furkhangul/Handpilot-Car/docs/templates/HAFTALIK_RAPOR.md

# HandPilot-Car · Haftalık Rapor H? (GG–GG Ay 2026)

**Ekip:** Furkan Gül · Sibel Akardaş · Hazal Kanik · Sinem Bolat · Reyyan Ceyda Can · Recep Özkan · Sefa Eren Yalçın · Amadou Billy Sidibe

## Haftanın özeti

<!-- 2–3 cümle: bu hafta hangi kapıdan geçildi, hangi çıktı var? -->

## Yapılanlar

| Tarih | İş | Sorumlu | Çıktı |
|---|---|---|---|
| | | | |

## Ölçümler

| Kriter | Hedef | Bu hafta | Durum |
|---|---|---|---|
| K? | | | ✅ / ⚠️ / ❌ |

## Sorunlar ve çözümler

| Sorun | Etki | Çözüm / karar |
|---|---|---|
| | | |

## Gelecek haftaya devreden

-

## Cuma çıktısı

- Video: <!-- link -->
- Log / grafik: <!-- link -->
