furkhangul/Handpilot-Car/docs/templates/RIZA_FORMU.md

# Açık Rıza Formu · HandPilot-Car Veri Seti

> Şablon. Çıktısı alınıp imzalanır; **imzalı formlar repoya yüklenmez**, ekip liderinde saklanır (README §9.7).

**Proje:** HandPilot-Car — el hareketiyle sürülen araç (ders projesi)
**Veri sorumlusu (ekip lideri):** Furkan Gül

## Toplanan veri

- Laptop kamerasıyla çekilen el hareketi fotoğrafları (640×480). Fotoğraflarda **yüzüm de görünebilir**.
- Her fotoğrafın hangi hareket, tur ve zamana ait olduğunu gösteren kayıt dosyası.
- Gerçek adım yerine bir **katılımcı kodu** kullanılır: `p__`.

## Amaç ve süre

- Veri **yalnızca** bu ders projesinde hareket tanıma modelini eğitmek ve test etmek için kullanılır.
- Ham görüntüler herkese açık bir yere (GitHub dahil) yüklenmez. Repoya yalnızca yüz içermeyen sayısal el noktaları (`landmarks.csv`) girebilir.
- Saklama süresi: proje bitimi + 1 yıl. Sonra silinir.

## Haklarım

- Rızamı istediğim zaman geri çekebilirim; verilerim silinir ve model yeniden eğitilir.
- Verilerimin silindiğine dair bilgi isteyebilirim.

Yukarıdakileri okudum ve el hareketi fotoğraflarımın bu amaçla kullanılmasına **açık rıza veriyorum**.

| | |
|---|---|
| Ad Soyad | |
| Katılımcı kodu | p__ |
| Tarih | |
| İmza | |
