furkhangul/Handpilot-Car/models/furkan/v1_cnn/figures/finetune_loss.png

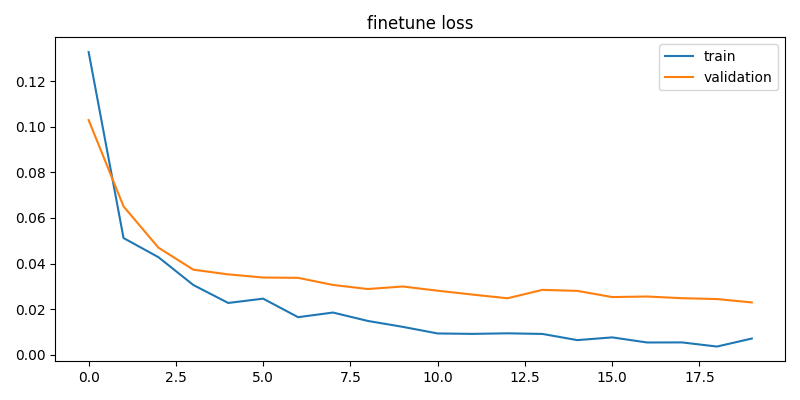
models/furkan/v1_cnn/figures/finetune_loss.png
