furkhangul/Handpilot-Car/models/furkan/v1_cnn/figures/head_loss.png

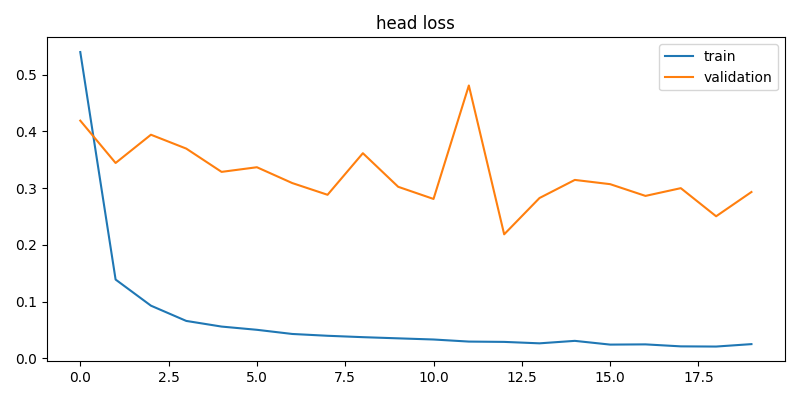
models/furkan/v1_cnn/figures/head_loss.png
