furkhangul/Handpilot-Car/models/furkan/v1_cnn/reports/test_confusion_normalized.csv

 | fren | gaz | sag | sol
fren | 1.0 | 0.0 | 0.0 | 0.0
gaz | 0.0 | 1.0 | 0.0 | 0.0
sag | 0.0 | 0.0 | 0.989010989010989 | 0.01098901098901099
sol | 0.08423326133909287 | 0.11447084233261338 | 0.0021598272138228943 | 0.7991360691144709
