furkhangul/Handpilot-Car/models/furkan/v1_cnn/reports/test_confusion_raw.csv

 | fren | gaz | sag | sol
fren | 500 | 0 | 0 | 0
gaz | 0 | 394 | 0 | 0
sag | 0 | 0 | 450 | 5
sol | 39 | 53 | 1 | 370
