furkhangul/Handpilot-Car/models/furkan/v1_cnn/reports/test_confusion.png

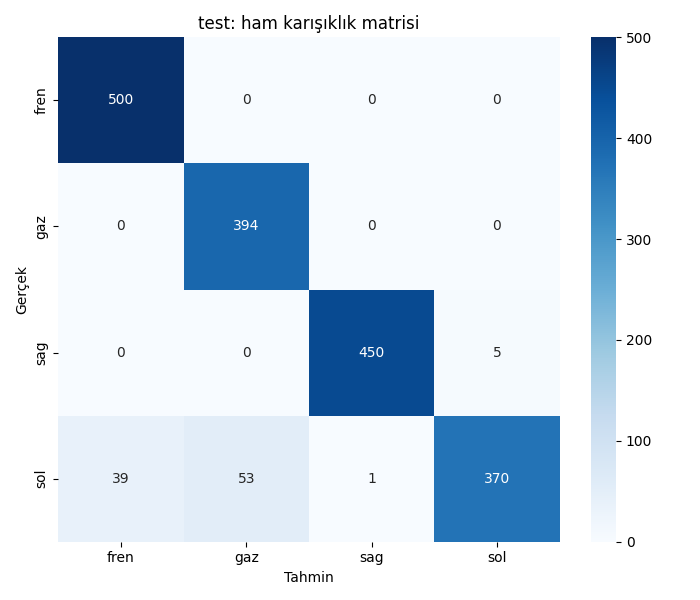
models/furkan/v1_cnn/reports/test_confusion.png
