furkhangul/Handpilot-Car/models/furkan/v1_cnn/reports/test_roc.png

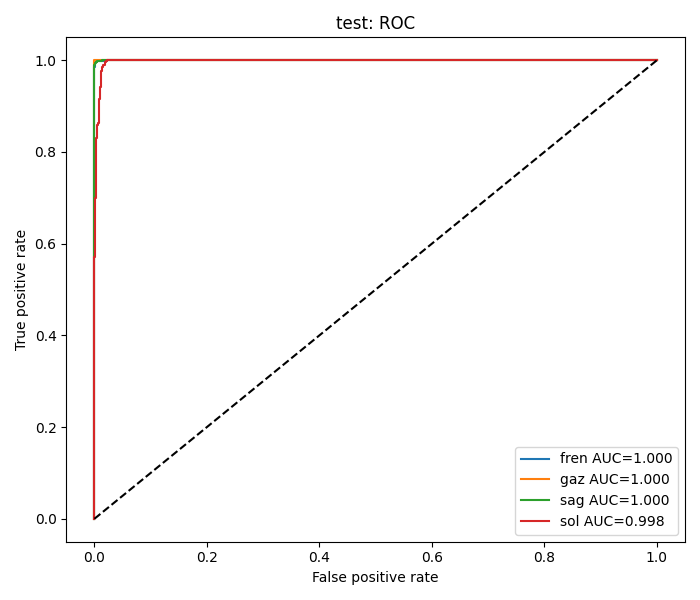
models/furkan/v1_cnn/reports/test_roc.png
