furkhangul/Handpilot-Car/firmware/handpilot_esp32/wifi_secrets.example.h

// Bu dosyayı wifi_secrets.h adıyla kopyalayıp kendi ev WiFi'ınızı yazın (2.4 GHz ağ olmalı).
// wifi_secrets.h yoksa ya da ağ bulunamazsa araç kendi HandPilot-Car ağını açar.
#pragma once
#define HOME_SSID      ""
#define HOME_PASSWORD  ""
