furkhangul/Handpilot-Car/(commit log)

2026-10-25 Add Furkan's MobileNetV3Small model and reports
    [counts_by_person_round.csv, counts_by_person_session.csv, mediapipe_failures.csv, rejected_records.csv, test_confusion_normalized.csv, test_confusion_raw.csv]
2026-10-26 Furkan: add v2 landmark MLP model, move CNN to v1_cnn
    [counts_by_person_round.csv, counts_by_person_session.csv, mediapipe_failures.csv, rejected_records.csv, test_confusion_normalized.csv, test_confusion_raw.csv]
2026-10-28 h4-furkan: ESP32 firmware, 4 modelin ortak kararı ve ileri/geri/sağ/sol hareketleri
    - firmware/handpilot_esp32: TB6612FNG, WiFi AP, /cmd /stop /status, 1 sn watchdog,
    ileri/geri/kavis/yerinde dönüş, telefondan /kumanda test sayfası
    - handpilot/: Sinem, Reyyan, Sibel, Hazal modelleri TFLite ile ortak karar (gesture.py),
    durum makinesi (controller.py), arka plan gönderici (car_client.py), ekran (ui.py)
    - 👎 yumruk + başparmak aşağı = geri (geometriden), dururken ⬅️/➡️ = yerinde dönüş
    - tools/export_models.py (Keras -> TFLite), tools/arac_testi.py (motor yön testi)
    - README v5.3: protokolde d ∈ {1, -1, 0}, /kumanda; D4 ve D7 güncellendi
    - 28 test (controller, öz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
2026-10-28 ESP32 yükleme betiği eklendi, derleme çıktısı yok sayıldı
